zibredlektab/MFSerial/README.md

# MFSerial
Microforce Analog to Preston Serial converter
