zibredlektab/MFSerial/(list of files, cad)

Other CAD files:
MFSerial Proto/Case/MFProto Case v8.f3d
