zibredlektab/MFSerial/Production v1.2/Production v1.2.kicad_pcb

## KiCad design Production v1.2/Production v1.2.kicad_pcb (2025-05-16)

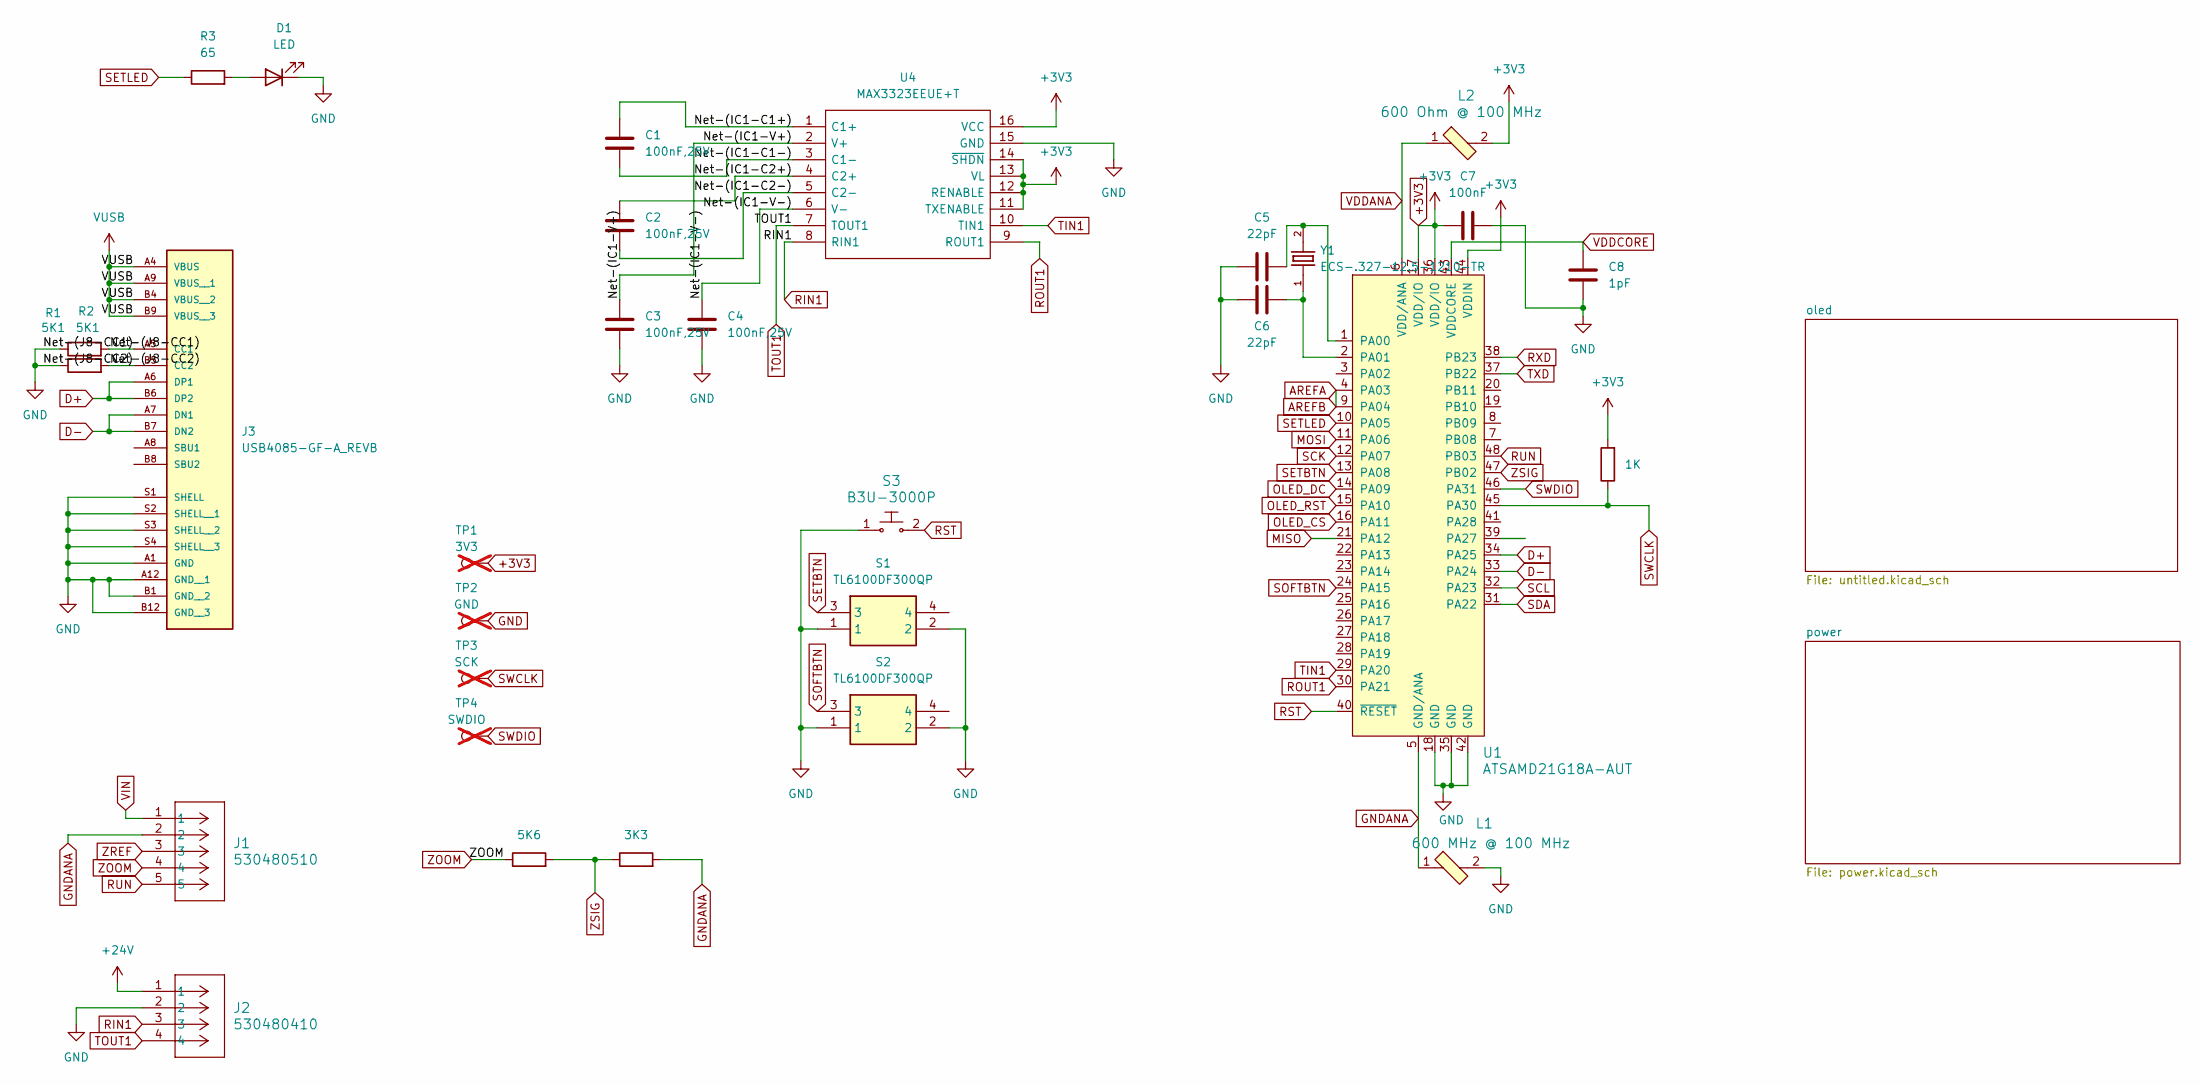
[picture p1: schematic Production v1.2.kicad_sch]

Parts:
C1, C2, C3, C4: 100nF,25V; C_0402_1005Metric; Part Number CL05B104KA5NNNC
C5, C6: 22pF; C_0402_1005Metric; Part Number CL05C220JB51PNC
C7: 100nF; C_0402_1005Metric; Part Number CL05B104KA5NNNC
C8: 1pF; C_0402_1005Metric; Part Number CL05C010CB5NNNC
D1: LED; LED_0805_2012Metric; Part Number B1701URO-20D000114U1930
J1: 530480510; Molex_PicoBlade_53048-0510_1x05_P1.25mm_Horizontal; Part Number 530480510
J2: 530480410; Molex_PicoBlade_53048-0410_1x04_P1.25mm_Horizontal; Part Number 530480410
J3: USB4085-GF-A_REVB; CONN16_USB4085-GF-A_GCT; Part Number USB4085-GF-A
L1: 600 MHz @ 100 MHz; 0603; Part Number 74269262601
L2: 600 Ohm @ 100 MHz; 0603; Part Number 74269262601
R1, R2: 5K1; R_0201_0603Metric; Part Number ERJ-1GNF5101C
R3: 65; R_0201_0603Metric; Part Number ERJ-1GNF64R9C
R4: 5K6; R_0402_1005Metric; Part Number ERA-2VRW5601X
R5: 3K3; R_0402_1005Metric; Part Number ERA-2VRW3301X
R6: 1K; R_0201_0603Metric; Part Number RC0201FR-071KL
S1, S2: TL6100DF300QP; TL6100DF160QP; Part Number TL6100DF300QP
S3: B3U-3000P; SW_SPST_B3U-3000P; Part Number B3U-3000P
TP1: 3V3; TestPoint_Pad_1.0x1.0mm; not fitted
TP2: GND; TestPoint_Pad_1.0x1.0mm; not fitted
TP3: SCK; TestPoint_Pad_1.0x1.0mm; not fitted
TP4: SWDIO; TestPoint_Pad_1.0x1.0mm; not fitted
U1: ATSAMD21G18A-AUT; TQFP-48_7x7mm_P0.5mm; Part Number ATSAMD21G18A-AUT
U4: MAX3323EEUE+T; TSSOP-16_4.4x5mm_P0.65mm; Part Number MAX3323EEUE+T
Y1: ECS-.327-12.5-1210-TR; XTAL_ECS-.327-12.5-1210-TR; Part Number ECS-.327-12.5-1210-TR

Connections:
+3V3: C7.1, L2.2, R6.2, TP1.1, U1.17 (VDD/IO), U1.36 (VDD/IO), U1.44 (VDDIN), U4.11 (TXENABLE), U4.12 (RENABLE), U4.13 (VL), U4.14 (~SHDN), U4.16 (VCC); also elsewhere on the board
+24V: J2.1; also elsewhere on the board
/Net-(IC1-C1+): C1.1, U4.1 (C1+)
/Net-(IC1-C1-): C1.2, U4.3 (C1-)
/Net-(IC1-C2+): C2.1, U4.4 (C2+)
/Net-(IC1-C2-): C2.2, U4.5 (C2-)
/Net-(IC1-V+): C3.1, U4.2 (V+)
/Net-(IC1-V-): C4.1, U4.6 (V-)
/Net-(J8-CC1): J3.A5 (CC1), R1.2
/Net-(J8-CC2): J3.B5 (CC2), R2.2
AREFA: U1.4 (PA03), U1.9 (PA04); also elsewhere on the board
D+: J3.A6 (DP1), J3.B6 (DP2), U1.34 (PA25)
D-: J3.A7 (DN1), J3.B7 (DN2), U1.33 (PA24)
GND: C3.2, C4.2, C5.1, C6.1, C7.2, C8.2, D1.1 (K), J2.2, J3.A1 (GND), J3.A12 (GND__1), J3.B1 (GND__2), J3.B12 (GND__3), J3.S1 (SHELL), J3.S2 (SHELL__1), J3.S3 (SHELL__2), J3.S4 (SHELL__3), L1.2, R1.1, R2.1, S1.1, S1.2, S2.1, S2.2, S3.1, TP2.1, U1.18 (GND), U1.35 (GND), U1.42 (GND), U4.15 (GND); also elsewhere on the board
GNDANA: J1.2, L1.1, R5.2, U1.5 (GND/ANA); also elsewhere on the board
MISO: U1.21 (PA12)
MOSI: U1.11 (PA06); also elsewhere on the board
unnamed: D1.2 (A), R3.2
unnamed: C5.2, U1.1 (PA00), Y1.2
unnamed: C6.2, U1.2 (PA01), Y1.1
OLED_CS: U1.16 (PA11); also elsewhere on the board
OLED_DC: U1.14 (PA09); also elsewhere on the board
OLED_RST: U1.15 (PA10); also elsewhere on the board
RIN1: J2.3, U4.8 (RIN1)
ROUT1: U1.30 (PA21), U4.9 (ROUT1)
RST: S3.2, U1.40 (~RESET)
RUN: J1.5, U1.48 (PB03)
RXD: U1.38 (PB23)
SCK: U1.12 (PA07); also elsewhere on the board
SCL: U1.32 (PA23)
SDA: U1.31 (PA22)
SETBTN: S1.3, U1.13 (PA08)
SETLED: R3.1, U1.10 (PA05)
SOFTBTN: S2.3, U1.24 (PA15)
SWCLK: R6.1, TP3.1, U1.45 (PA30)
SWDIO: TP4.1, U1.46 (PA31)
TIN1: U1.29 (PA20), U4.10 (TIN1)
TOUT1: J2.4, U4.7 (TOUT1)
TXD: U1.37 (PB22)
VDDANA: L2.1, U1.6 (VDD/ANA); also elsewhere on the board
VDDCORE: C8.1, U1.43 (VDDCORE)
VIN: J1.1; also elsewhere on the board
VUSB: J3.A4 (VBUS), J3.A9 (VBUS__1), J3.B4 (VBUS__2), J3.B9 (VBUS__3); also elsewhere on the board
ZOOM: J1.4, R4.1
ZREF: J1.3; also elsewhere on the board
ZSIG: R4.2, R5.1, U1.47 (PB02)

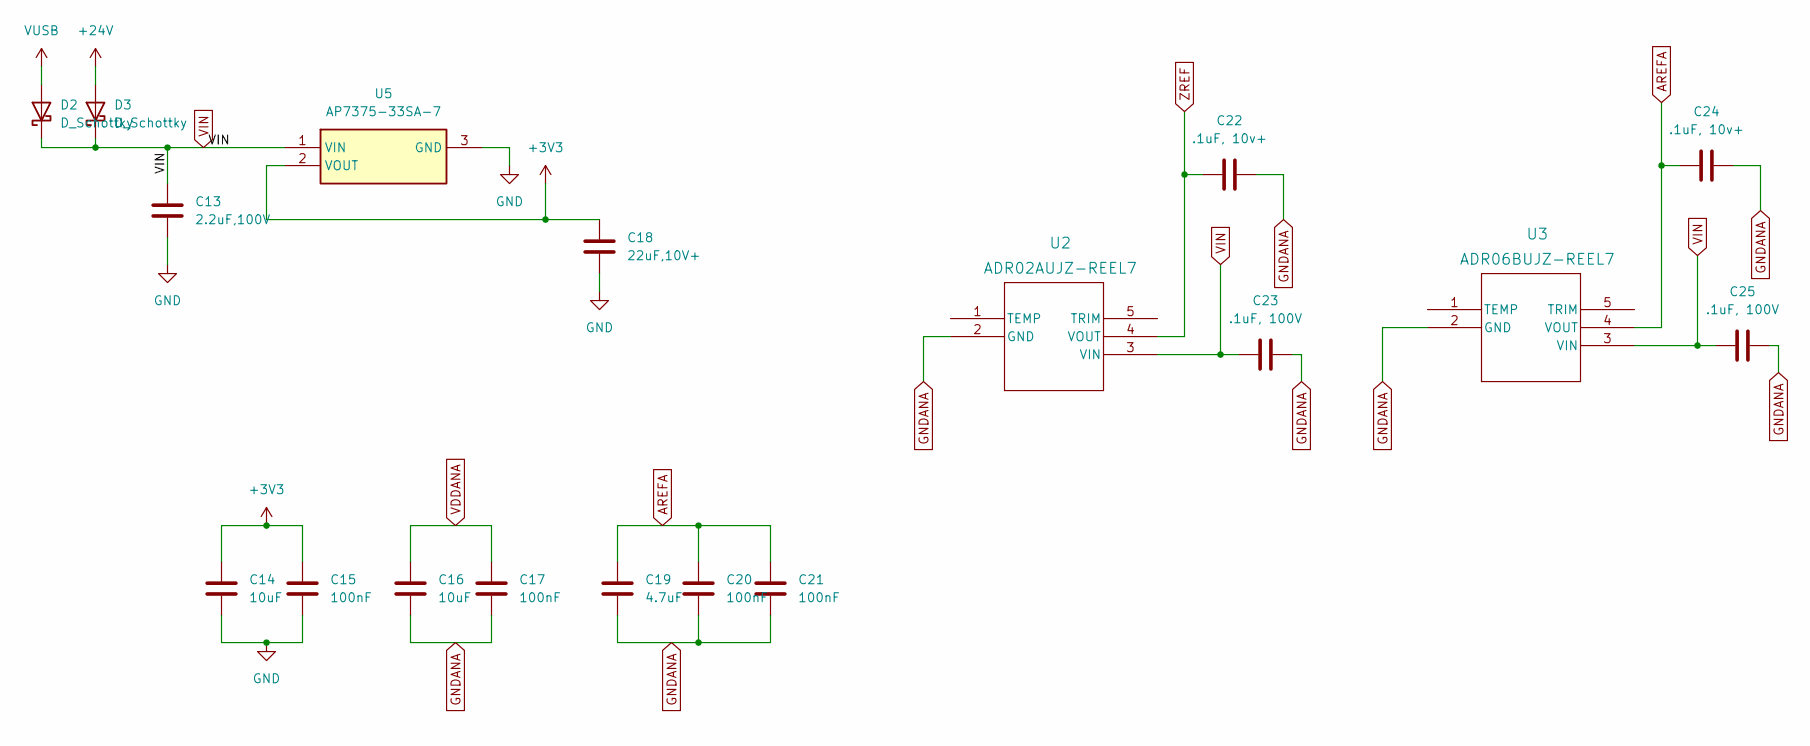
[picture p2: schematic power.kicad_sch]

Parts:
C13: 2.2uF,100V; C_0805_2012Metric; Part Number C2012X7R2A225K125AC
C14, C16: 10uF; C_0402_1005Metric; Part Number GRM155R61A106ME11D
C15, C17, C20, C21: 100nF; C_0402_1005Metric; Part Number CL05B104KA5NNNC
C18: 22uF,10V+; C_0402_1005Metric; Part Number GRM158R61A226ME15D
C19: 4.7uF; C_0402_1005Metric; Part Number CL05A475MP5NRNC
C22, C24: .1uF, 10v+; C_0402_1005Metric; Part Number CL05B104KP5NNNC
C23, C25: .1uF, 100V; C_0805_2012Metric; Part Number CL21B104KCFNNNE
D2, D3: D_Schottky; D_1206_3216Metric; Part Number SD1206S100S1R0
U2: ADR02AUJZ-REEL7; TSOT-23-5; Part Number ADR02AUJZ-REEL7
U3: ADR06BUJZ-REEL7; TSOT-23-5; Part Number ADR06BUJZ-REEL7
U5: AP7375-33SA-7; SOT96P240X110-3N; Part Number AP7375-33SA-7

Connections:
+3V3: C14.1, C15.1, C18.2, U5.2 (VOUT); also elsewhere on the board
+24V: D3.2 (A); also elsewhere on the board
AREFA: C19.1, C20.1, C21.1, C24.2, U3.4 (VOUT); also elsewhere on the board
GND: C13.1, C14.2, C15.2, C18.1, U5.3 (GND); also elsewhere on the board
GNDANA: C16.2, C17.2, C19.2, C20.2, C21.2, C22.1, C23.1, C24.1, C25.1, U2.2 (GND), U3.2 (GND); also elsewhere on the board
VDDANA: C16.1, C17.1; also elsewhere on the board
VIN: C13.2, C23.2, C25.2, D2.1 (K), D3.1 (K), U2.3 (VIN), U3.3 (VIN), U5.1 (VIN); also elsewhere on the board
VUSB: D2.2 (A); also elsewhere on the board
ZREF: C22.2, U2.4 (VOUT); also elsewhere on the board

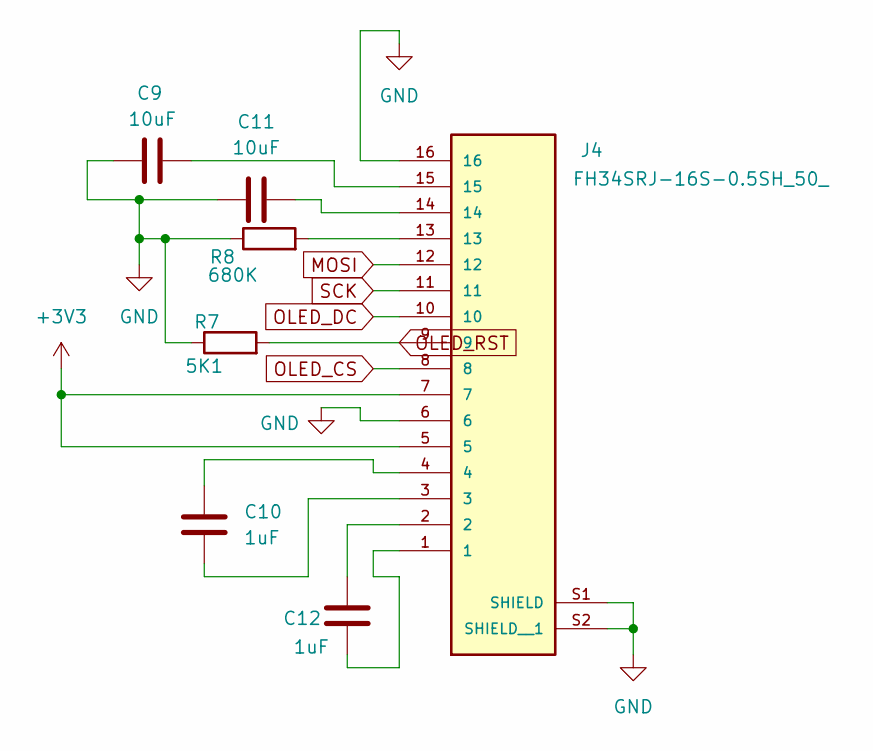
[picture p3: schematic untitled.kicad_sch]

Parts:
C9, C11: 10uF; C_0603_1608Metric; Part Number CL10A106KQ8NNNL
C10, C12: 1uF; C_0603_1608Metric; Part Number CL10B105KP8NNNC
J4: FH34SRJ-16S-0.5SH_50_; HRS_FH34SRJ-16S-0.5SH_50_; Part Number FH34SRJ-16S-0.5SH(50)
R7: 5K1; R_0201_0603Metric; Part Number ERJ-1GNF5101C
R8: 680K; R_0201_0603Metric; Part Number ERJ-1GNF6803C

Connections:
+3V3: J4.5, J4.7; also elsewhere on the board
GND: C9.1, C11.2, J4.6, J4.16, J4.S1 (SHIELD), J4.S2 (SHIELD__1), R7.1, R8.1; also elsewhere on the board
MOSI: J4.12; also elsewhere on the board
unnamed: C9.2, J4.15
unnamed: C10.1, J4.3
unnamed: C10.2, J4.4
unnamed: C11.1, J4.14
unnamed: C12.1, J4.1
unnamed: C12.2, J4.2
unnamed: J4.13, R8.2
OLED_CS: J4.8; also elsewhere on the board
OLED_DC: J4.10; also elsewhere on the board
OLED_RST: J4.9, R7.2; also elsewhere on the board
SCK: J4.11; also elsewhere on the board

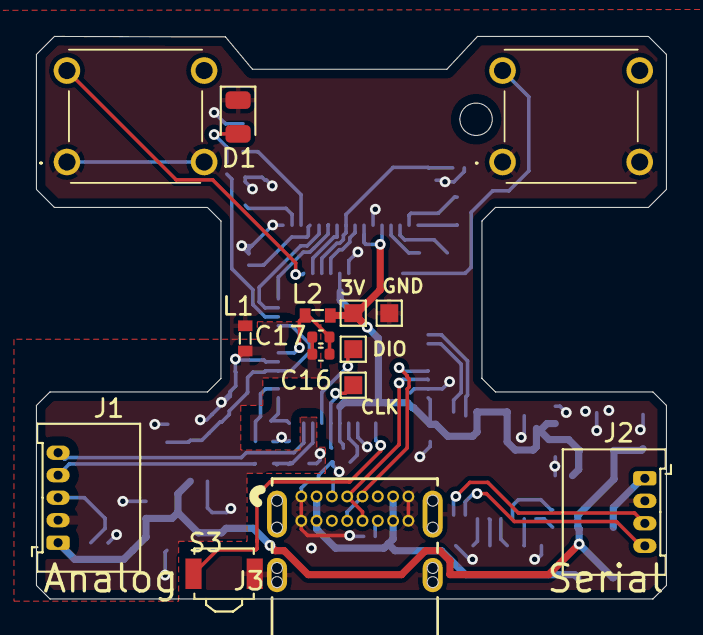
[picture p4: board Production v1.2.kicad_pcb from above]

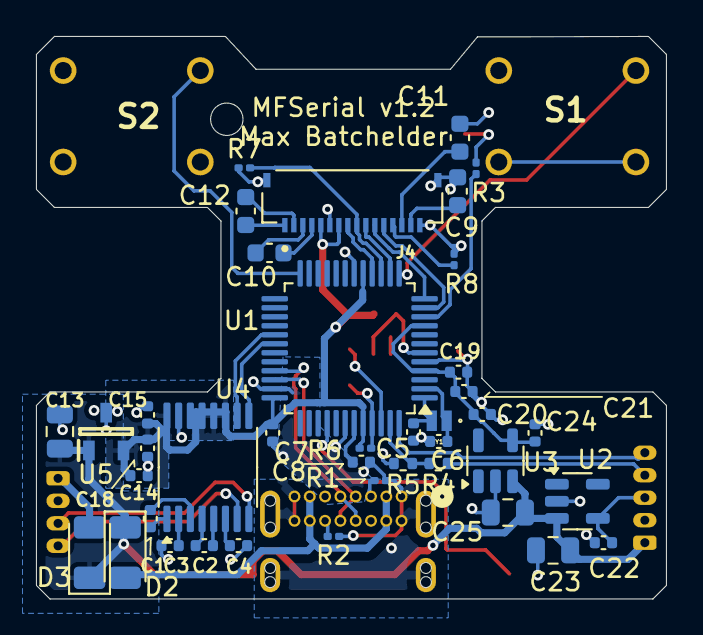
[picture p5: board Production v1.2.kicad_pcb from below]

Board: 2 copper layers, 35.0 x 31.2 mm, 55 parts (40 on the bottom side), 48 nets.
