zibredlektab/MFSerial/Production v1.1/Production v1.1.kicad_pcb

## KiCad design Production v1.1/Production v1.1.kicad_pcb (2024-11-22, an earlier design)

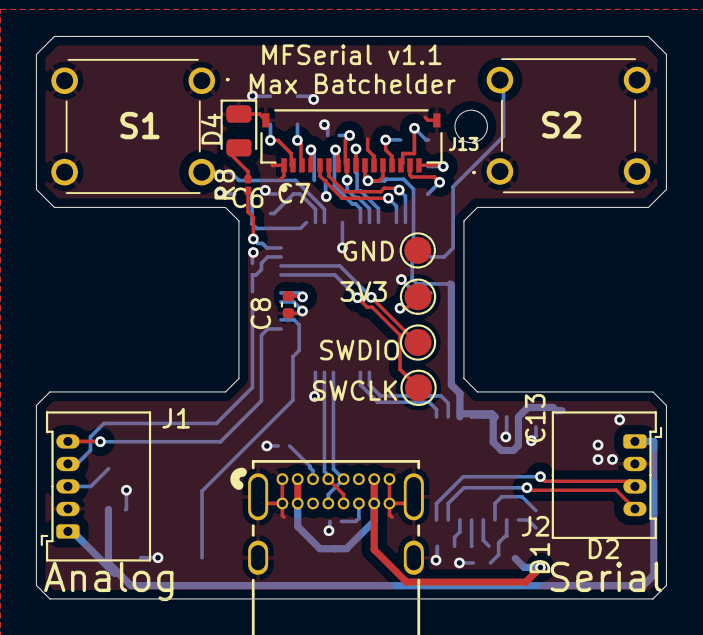
[picture p6: board Production v1.1.kicad_pcb from above]

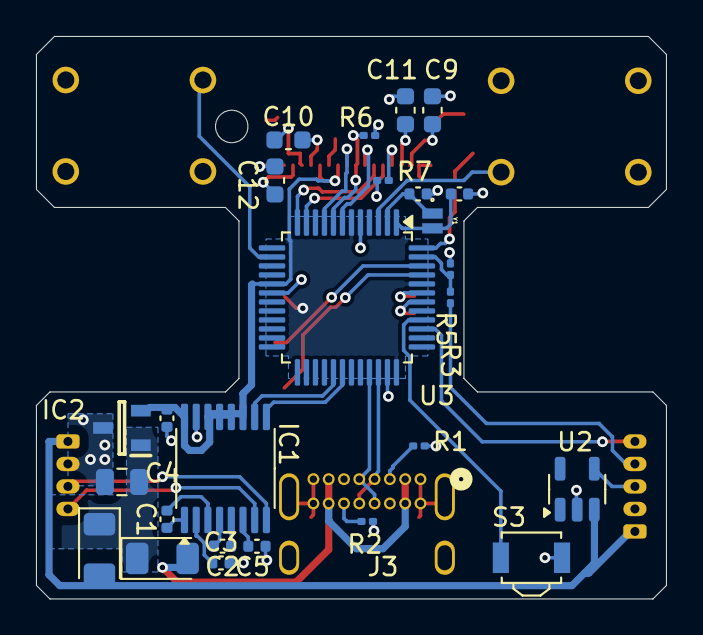
[picture p7: board Production v1.1.kicad_pcb from below]

Board: 2 copper layers, 35.0 x 31.2 mm, 39 parts (26 on the bottom side), 45 nets.

Parts:
3V3: TestPoint_Pad_D1.5mm
C1, C2, C3, C5: 100nF,24V+; C_0402_1005Metric
C4: 2.2uF,100V; C_0805_2012Metric
C6, C7: 22pF; C_0402_1005Metric
C8: 1pF; C_0402_1005Metric
C9, C11: 10uF; C_0603_1608Metric
C10, C12: 1uF; C_0603_1608Metric
C13: 22uF,10V+; C_0402_1005Metric
D1, D2: D_Schottky; D_1206_3216Metric
D4: LED; LED_0805_2012Metric
GND: TestPoint_Pad_D1.5mm
IC1: MAX3323EEUE+T; TSSOP-16_4.4x5mm_P0.65mm
IC2: AP7375-33SA-7; SOT96P240X110-3N
J1: 530480510; Molex_PicoBlade_53048-0510_1x05_P1.25mm_Horizontal
J2: 530480410; Molex_PicoBlade_53048-0410_1x04_P1.25mm_Horizontal
J3: USB4085-GF-A_REVB; CONN16_USB4085-GF-A_GCT
J13: FH34SRJ-16S-0.5SH_50_; HRS_FH34SRJ-16S-0.5SH_50_
R1, R2, R6: 5K1; R_0201_0603Metric
R3: 4K7; R_0201_0603Metric
R5: 3K3; R_0201_0603Metric
R7: 680K; R_0201_0603Metric
R8: 65; R_0201_0603Metric
S1, S2: TL6100DF300QP; TL6100DF160QP
S3: B3U-3000P; SW_SPST_B3U-3000P
SWCLK: TestPoint_Pad_D1.5mm
SWDIO: TestPoint_Pad_D1.5mm
U2: ADR02AUJZ-REEL7; TSOT-23-5
U3: ATSAMD21G18A-AUT; TQFP-48_7x7mm_P0.5mm
Y1: ECS-.327-12.5-1210-TR; XTAL_ECS-.327-12.5-1210-TR

Connections:
+3V3: 3V3.3, C13.2, IC1.11 (TXENABLE), IC1.12 (RENABLE), IC1.13 (VL), IC1.14 (~SHDN), IC1.16 (VCC), IC2.2 (VOUT), J13.10, J13.12, U3.6 (VDD/ANA), U3.17 (VDD/IO), U3.36 (VDD/IO), U3.44 (VDDIN)
+24V: D2.2 (A), J1.1, J2.1, U2.3 (VIN)
/Net-(IC1-C1+): C1.1, IC1.1 (C1+)
/Net-(IC1-C1-): C1.2, IC1.3 (C1-)
/Net-(IC1-C2+): C2.1, IC1.4 (C2+)
/Net-(IC1-C2-): C2.2, IC1.5 (C2-)
/Net-(IC1-V+): C3.1, IC1.2 (V+)
/Net-(IC1-V-): C5.1, IC1.6 (V-)
/Net-(J8-CC1): J3.A5 (CC1), R1.2
/Net-(J8-CC2): J3.B5 (CC2), R2.2
D+: J3.A6 (DP1), J3.B6 (DP2), U3.34 (PA25)
D-: J3.A7 (DN1), J3.B7 (DN2), U3.33 (PA24)
GND: C3.2, C4.1, C5.2, C6.1, C7.1, C8.2, C9.1, C11.2, C13.1, D4.1 (K), GND.4, IC1.15 (GND), IC2.3 (GND), J1.2, J2.2, J3.A1 (GND), J3.A12 (GND__1), J3.B1 (GND__2), J3.B12 (GND__3), J3.S1 (SHELL), J3.S2 (SHELL__1), J3.S3 (SHELL__2), J3.S4 (SHELL__3), J13.1, J13.11, J13.S1 (SHIELD), J13.S2 (SHIELD__1), R1.1, R2.1, R5.2, R6.1, R7.1, S1.1, S1.2, S1.4, S2.1, S2.2, S2.4, S3.1, U2.2 (GND), U3.5 (GND/ANA), U3.18 (GND), U3.35 (GND), U3.42 (GND)
MOSI: J13.5, U3.11 (PA06)
unnamed: C9.2, J13.2
unnamed: C10.1, J13.14
unnamed: C10.2, J13.13
unnamed: C11.1, J13.3
unnamed: C12.1, J13.16
unnamed: C12.2, J13.15
unnamed: D4.2 (A), R8.2
unnamed: J13.4, R7.2
unnamed: C6.2, U3.1 (PA00), Y1.2
unnamed: C7.2, U3.2 (PA01), Y1.1
unnamed: C8.1, U3.43 (VDDCORE)
OLED_CS: J13.9, U3.9 (PA04)
OLED_DC: J13.7, U3.7 (PB08)
OLED_RST: J13.8, R6.2, U3.8 (PB09)
RIN1: IC1.8 (RIN1), J2.3
ROUT1: IC1.9 (ROUT1), U3.30 (PA21)
RST: S3.2, U3.40 (~RESET)
RUN: J1.5, U3.39 (PA27)
SCK: J13.6, U3.12 (PA07)
SETBTN: S1.3, U3.3 (PA02)
SETLED: R8.1, U3.48 (PB03)
SOFTBTN: S2.3, U3.14 (PA09)
SWCLK: SWCLK.1, U3.45 (PA30)
SWDIO: SWDIO.3, U3.46 (PA31)
TIN1: IC1.10 (TIN1), U3.29 (PA20)
TOUT1: IC1.7 (TOUT1), J2.4
VIN: C4.2, D1.1 (K), D2.1 (K), IC2.1 (VIN)
VUSB: D1.2 (A), J3.A4 (VBUS), J3.A9 (VBUS__1), J3.B4 (VBUS__2), J3.B9 (VBUS__3)
ZOOM: J1.4, R3.1
ZREF: J1.3, U2.4 (VOUT)
ZSIG: R3.2, R5.1, U3.47 (PB02)
