zibredlektab/MFSerial/MFSerial Proto/MFSerial Proto.kicad_pcb

## KiCad design MFSerial Proto/MFSerial Proto.kicad_pcb (2024-05-30)

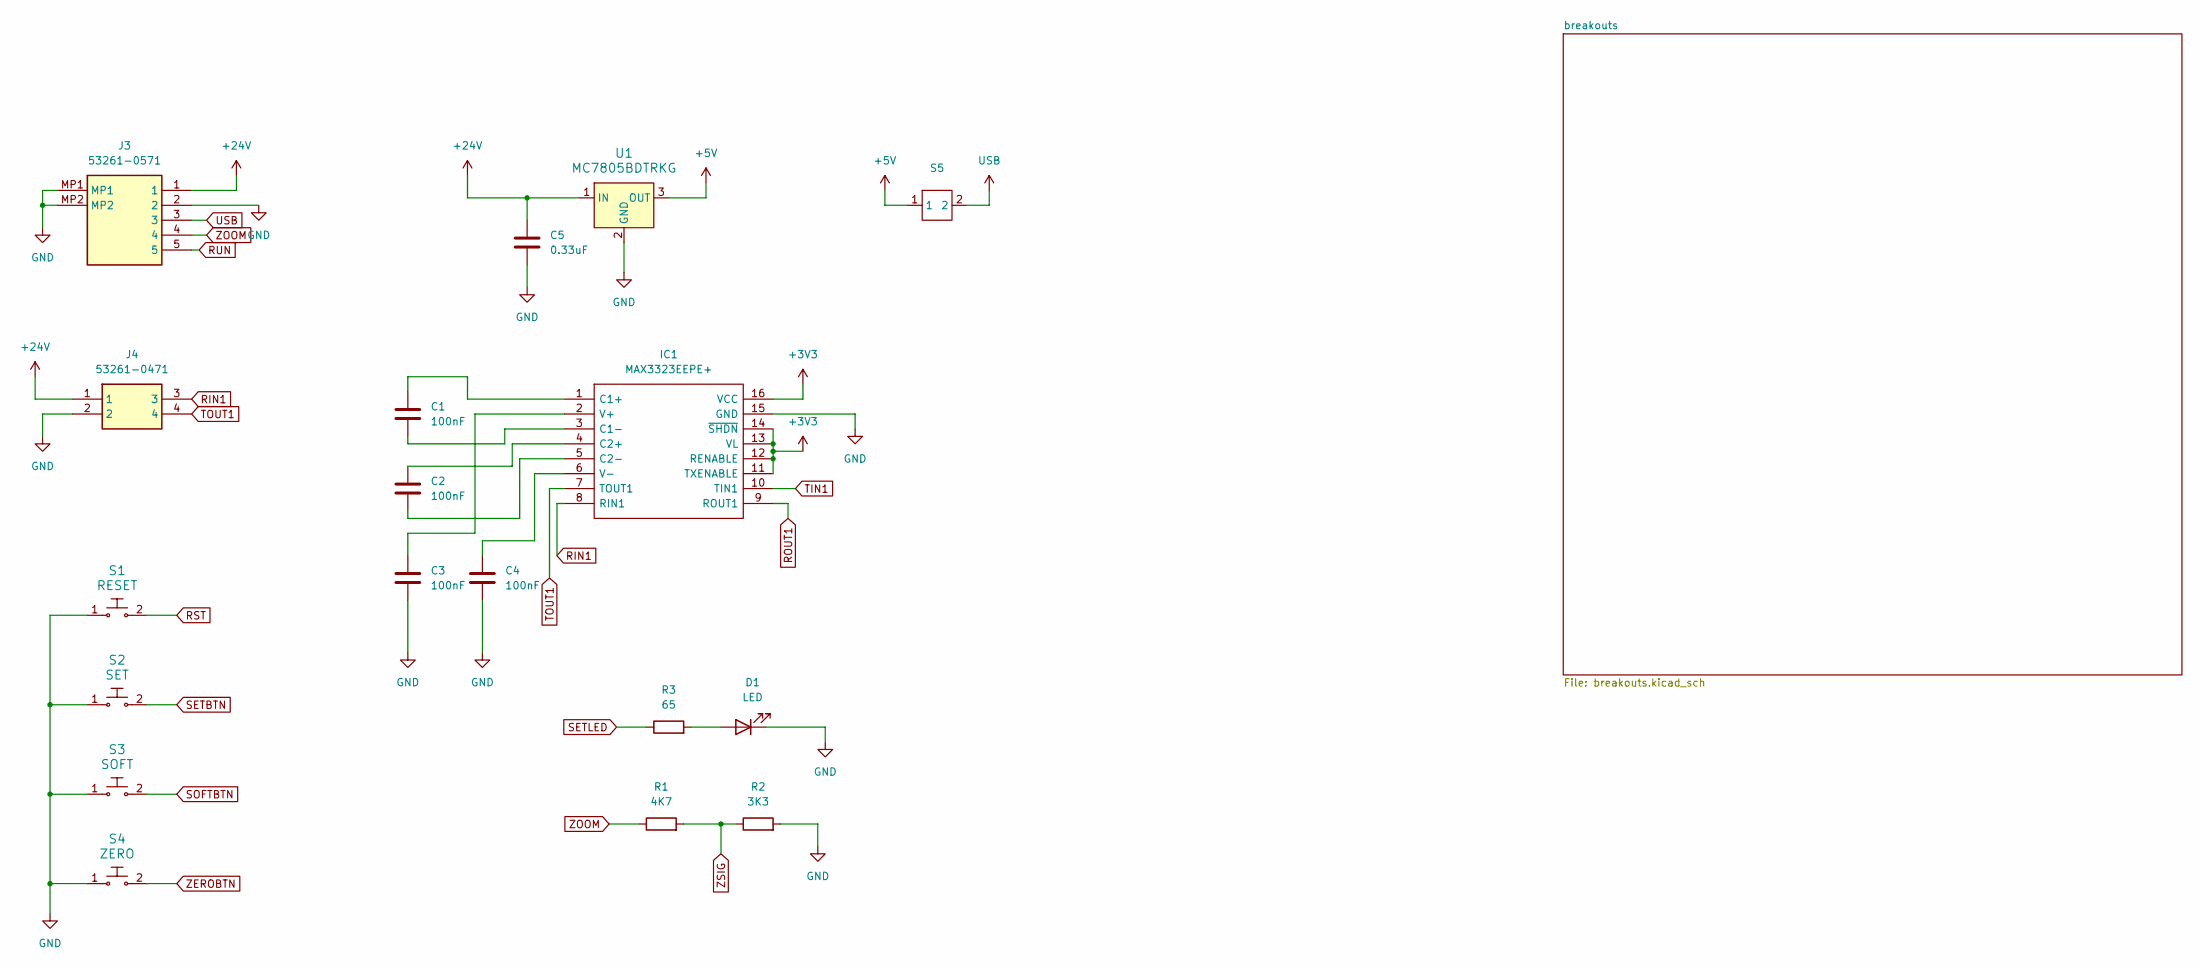
[picture p8: schematic MFSerial Proto.kicad_sch]

Parts:
C1, C2, C3, C4: 100nF; C_1812_4532Metric_Pad1.57x3.40mm_HandSolder
C5: 0.33uF; C_1812_4532Metric_Pad1.57x3.40mm_HandSolder
D1: LED; LED_5mm_Radial
IC1: MAX3323EEPE+; DIP794W56P254L1918H457Q16N; Mouser Part Number 700-MAX3323EEPE
J3: 53261-0571; 532610571TR250; Mouser Part Number 538-53261-0571
J4: 53261-0471; Mouser Part Number 538-53261-0471
R1: 4K7; R_1206_3216Metric_Pad1.30x1.75mm_HandSolder
R2: 3K3; R_1206_3216Metric_Pad1.30x1.75mm_HandSolder
R3: 65; R_1206_3216Metric_Pad1.30x1.75mm_HandSolder
S1: RESET; Switch_Tactile_SMD_B3U-1000P; MPN B3U-1000P
S2: SET; Switch_Tactile_SMD_B3U-1000P; MPN B3U-1000P
S3: SOFT; Switch_Tactile_SMD_B3U-1000P; MPN B3U-1000P
S4: ZERO; Switch_Tactile_SMD_B3U-1000P; MPN B3U-1000P
S5: DS04-254-1L-01
U1: MC7805BDTRKG; TO-220-3; MPN MC7805BDTRKG

Connections:
+3V3: IC1.11 (TXENABLE), IC1.12 (RENABLE), IC1.13 (VL), IC1.14 (~SHDN), IC1.16 (VCC); also elsewhere on the board
+5V: S5.1, U1.3 (OUT)
+24V: C5.2, J3.1, J4.1, U1.1 (IN); also elsewhere on the board
GND: C3.2, C4.2, C5.1, D1.1 (K), IC1.15 (GND), J3.2, J3.MP1, J3.MP2, J4.2, R2.2, S1.1, S2.1, S3.1, S4.1, U1.2 (GND); also elsewhere on the board
unnamed: D1.2 (A), R3.2
unnamed: C1.1, IC1.1 (C1+)
unnamed: C1.2, IC1.3 (C1-)
unnamed: C2.1, IC1.4 (C2+)
unnamed: C2.2, IC1.5 (C2-)
unnamed: C3.1, IC1.2 (V+)
unnamed: C4.1, IC1.6 (V-)
RIN1: IC1.8 (RIN1), J4.3; also elsewhere on the board
ROUT1: IC1.9 (ROUT1); also elsewhere on the board
RST: S1.2; also elsewhere on the board
RUN: J3.5; also elsewhere on the board
SETBTN: S2.2; also elsewhere on the board
SETLED: R3.1; also elsewhere on the board
SOFTBTN: S3.2; also elsewhere on the board
TIN1: IC1.10 (TIN1); also elsewhere on the board
TOUT1: IC1.7 (TOUT1), J4.4; also elsewhere on the board
USB: J3.3, S5.2; also elsewhere on the board
ZEROBTN: S4.2; also elsewhere on the board
ZOOM: J3.4, R1.1; also elsewhere on the board
ZSIG: R1.2, R2.1; also elsewhere on the board

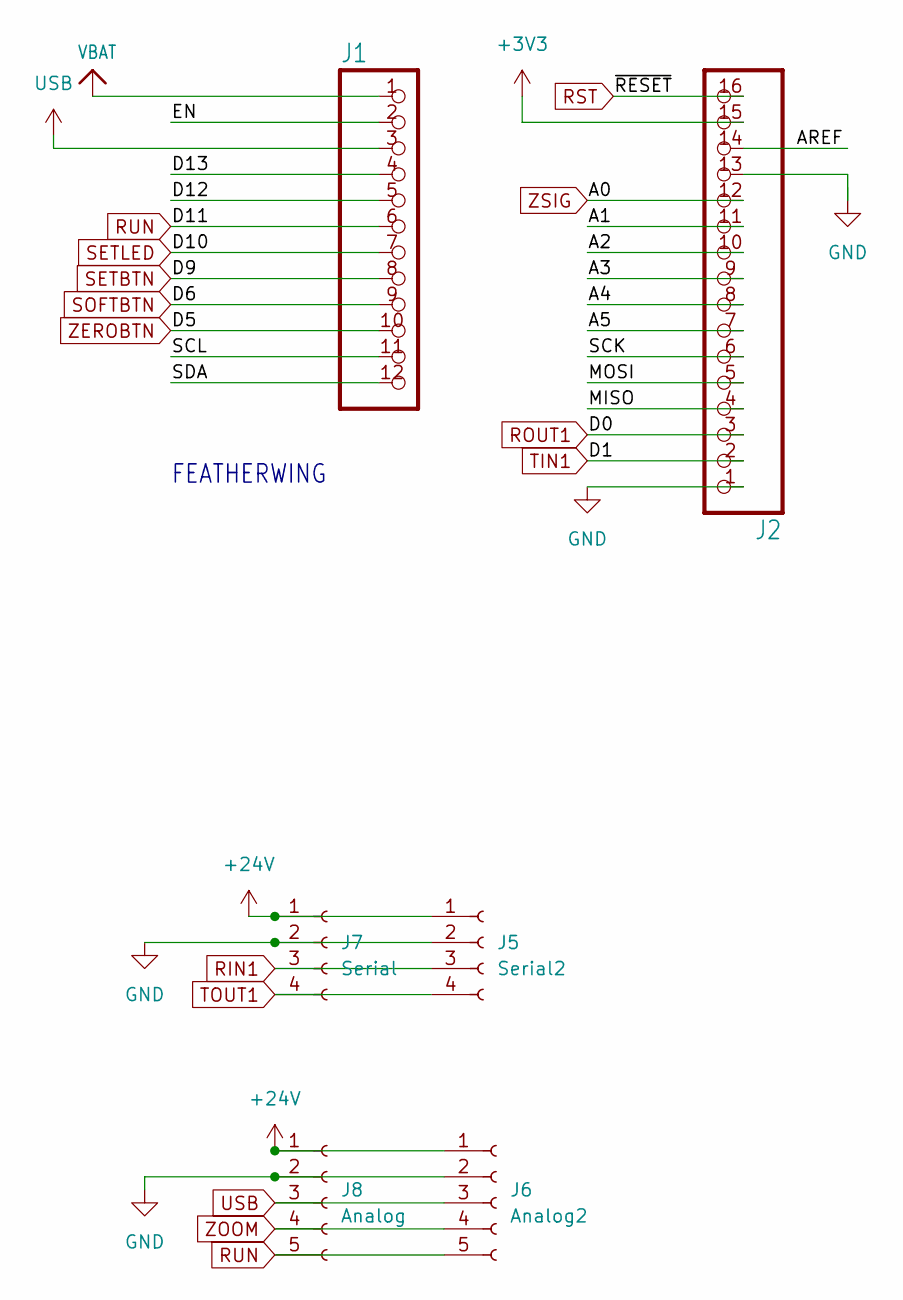
[picture p9: schematic breakouts.kicad_sch]

Parts:
J1: HEADER-1X12; PinHeader_1x12_P2.54mm_Vertical
J2: HEADER-1X16ROUND; PinHeader_1x16_P2.54mm_Vertical
J5: Serial2; PinSocket_1x04_P2.54mm_Vertical
J6: Analog2; PinSocket_1x05_P2.54mm_Vertical
J7: Serial; PinSocket_1x04_P2.54mm_Vertical
J8: Analog; PinSocket_1x05_P2.54mm_Vertical

Connections:
+3V3: J2.15; also elsewhere on the board
+24V: J5.1, J6.1, J7.1, J8.1; also elsewhere on the board
/breakouts/A1: J2.11
/breakouts/A2: J2.10
/breakouts/A3: J2.9
/breakouts/A4: J2.8
/breakouts/A5: J2.7
/breakouts/AREF: J2.14
/breakouts/D12: J1.5
/breakouts/D13: J1.4
/breakouts/EN: J1.2
/breakouts/MISO: J2.4
/breakouts/MOSI: J2.5
/breakouts/SCK: J2.6
/breakouts/SCL: J1.11
/breakouts/SDA: J1.12
GND: J2.1, J2.13, J5.2, J6.2, J7.2, J8.2; also elsewhere on the board
RIN1: J5.3, J7.3; also elsewhere on the board
ROUT1: J2.3; also elsewhere on the board
RST: J2.16; also elsewhere on the board
RUN: J1.6, J6.5, J8.5; also elsewhere on the board
SETBTN: J1.8; also elsewhere on the board
SETLED: J1.7; also elsewhere on the board
SOFTBTN: J1.9; also elsewhere on the board
TIN1: J2.2; also elsewhere on the board
TOUT1: J5.4, J7.4; also elsewhere on the board
USB: J1.3, J6.3, J8.3; also elsewhere on the board
VBAT: J1.1
ZEROBTN: J1.10; also elsewhere on the board
ZOOM: J6.4, J8.4; also elsewhere on the board
ZSIG: J2.12; also elsewhere on the board

Notes on the sheet:
FEATHERWING

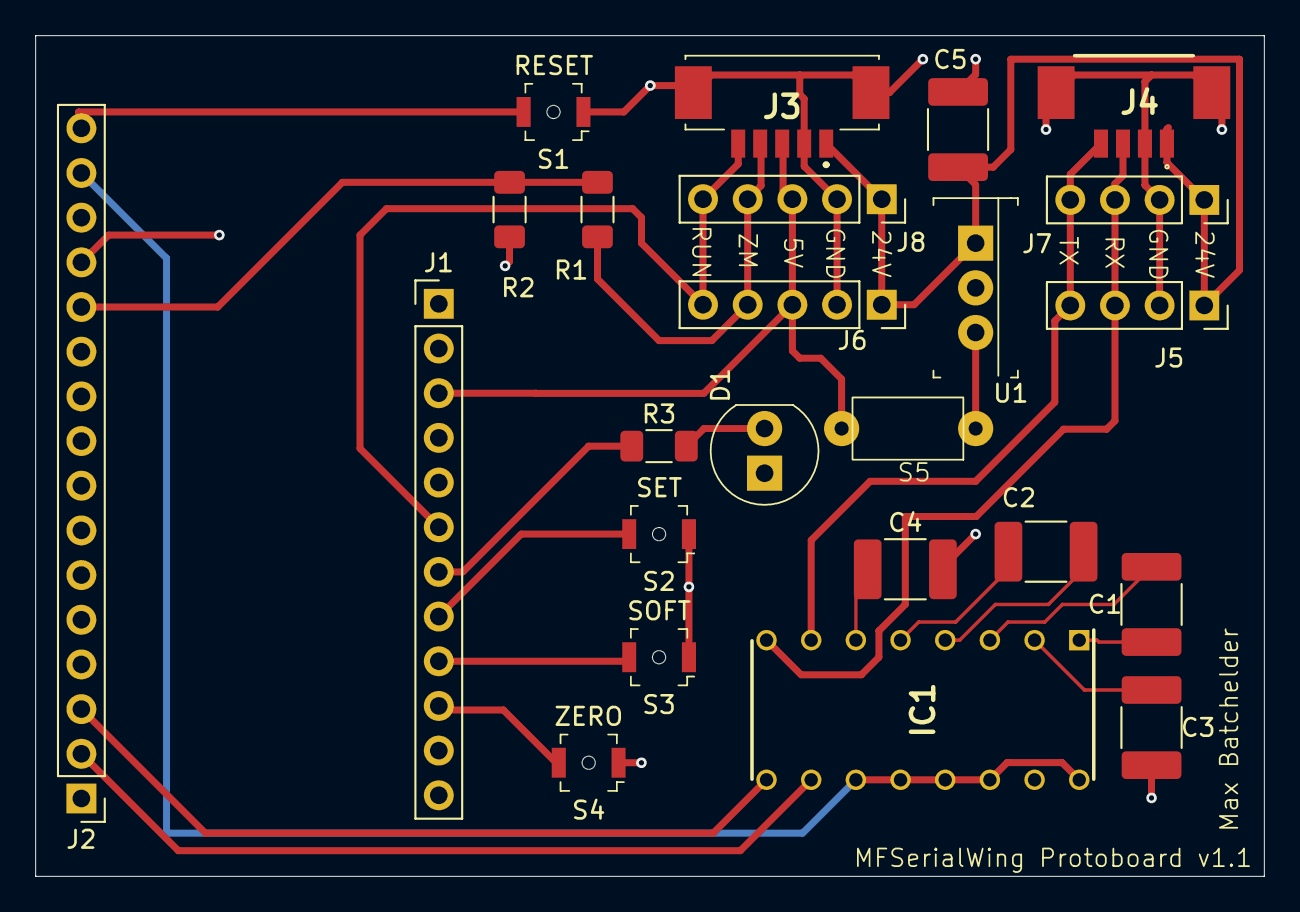
[picture p10: board MFSerial Proto.kicad_pcb from above]

Board: 2 copper layers, 69.9 x 47.8 mm, 24 parts (0 on the bottom side), 24 nets.
