zibredlektab/MFSerial/(commit log)

2024-05-30 Initial Commit
    MFSerialProto (featherwing design) and MFSerial Standalone (standalone prototype board), as ordered for manufacture
    [MFSerial Proto.kicad_pcb, MFSerial Proto.kicad_sch, Standalone.kicad_pcb, Standalone.kicad_sch, breakouts.kicad_sch, untitled.kicad_sch]
2024-05-30 Added f3d file for MFSerialProto case
    [MFProto Case v8.f3d]
2024-07-26 Started work on production board v1
    [BOM.csv, Production.kicad_pcb, Production.kicad_sch, breakouts.kicad_sch, untitled.kicad_sch]
2024-07-28 Solid layout, could be better
    [Production.kicad_pcb, Production.kicad_sch]
2024-07-28 Combined TXLED and SETLED
    [Production.kicad_pcb, Production.kicad_sch]
2024-07-29 I layout
    [Production.kicad_pcb, Production.kicad_sch, untitled.kicad_sch]
2024-08-01 Changing power regulator
    [Production.kicad_pcb, Production.kicad_sch, ProductionBOM.csv]
2024-08-09 Pretty solid I redesign
    Rotated mcu and reassigned pins for better layout, swapped ldo
    [Production.kicad_pcb, breakouts.kicad_sch, untitled.kicad_sch]
2024-08-09 more of previous
    [Production.kicad_sch]
2024-08-15 Unsure of what this change is, sorry
    [Production.kicad_pcb, Production.kicad_sch, ProductionBOM.csv, breakouts.kicad_sch, untitled.kicad_sch]
2024-08-15 Reloaded footprints & models after switching back to mac
    [Production.kicad_pcb, Production.kicad_sch, breakouts.kicad_sch, untitled.kicad_sch]
2024-08-16 Tweaked some cap sizes & layout accordingly
    [Production.kicad_pcb, untitled.kicad_sch]
2024-08-19 v1, as submitted for production
    [Production.kicad_pcb, Production.kicad_sch]
2024-08-20 Updated BOM to include part numbers
    [Production.kicad_sch, untitled.kicad_sch]
2024-09-14 Updated oled test arduino files
2024-10-22 Some minor board tweaks
    [BOM.csv, Production v2.kicad_pcb, Production v2.kicad_sch, Production.kicad_pcb, Production.kicad_sch, breakouts.kicad_sch, untitled.kicad_sch]
2024-11-12 Solid v1.1 attempt, but going to start over
    [BOM.csv, Production v1.1.kicad_pcb, Production v1.1.kicad_sch, Production v2.kicad_pcb, Production v2.kicad_sch, breakouts.kicad_sch, untitled.kicad_sch]
2024-11-15 Better v1.1, but I can do better
    [Production v1.1.kicad_pcb, Production v1.1.kicad_sch, untitled.kicad_sch]
2024-11-16 Components are all moved to the bottom layer, top is ground
    [Production v1.1.kicad_pcb, Production v1.1.kicad_sch, untitled.kicad_sch]
2024-11-18 Solid v1.1, but I want to change how the oled is mounted.
    [Production v1.1.kicad_pcb, Production v1.1.kicad_sch]
2024-11-19 v1.1 sent for assembly
    [Production v1.1.kicad_pcb, Production v1.1.kicad_sch, untitled.kicad_sch]
2024-11-21 Updated v1.1 and re-ordered
    One net was not connected
    [Production v1.1.kicad_pcb, Production v1.1.kicad_sch, untitled.kicad_sch]
2024-11-22 Resubmitted again, no more vias in pads
    [Production v1.1.kicad_pcb]
2025-03-14 Started v1.2
    [Production v1.2.kicad_pcb, Production v1.2.kicad_sch, breakouts.kicad_sch, power.kicad_sch, untitled.kicad_sch]
2025-03-15 1.2 routed
    [Production v1.2.kicad_pcb, Production v1.2.kicad_sch, power.kicad_sch, untitled.kicad_sch]
2025-03-15 v1.2 checked & labeled
    flipped fpc connector to underside, for better ribbon routing.
    [Production v1.2.kicad_pcb, Production v1.2.kicad_sch, power.kicad_sch, untitled.kicad_sch]
2025-03-24 Updated some fields
    [Production v1.2.kicad_pcb, Production v1.2.kicad_sch]
2025-05-16 Final tweaks for production v1.2, as manufactured
    [Production v1.2.kicad_pcb, Production v1.2.kicad_sch, power.kicad_sch, untitled.kicad_sch]
2025-10-07 updated uf2 board config
